mozhi66/smart-medicine-delivery-robot/项目介绍.md

# 智能药品小车 · 项目介绍

> 一台能听懂"我感冒了"、自己走到药架前、伸手把药取出来、还会提醒你怎么吃的智能药箱。
> 上位机 Python 负责「听、想、看」，下位机 STM32 负责「动」，两端用自定义串口协议通信。

---

## 一、项目要解决什么

家庭药箱的典型问题不是"没有药"，而是**找不到、记不住、拿不对**：

- 药盒堆在一起，临时找某种药要翻半天；
- 说明书上的用法用量看完就忘，老人尤其容易记混；
- 多种药混放，过期药和常用药分不清；
- 行动不便的人弯腰、伸手取药本身就有困难。

这个项目把"描述症状 → 拿到对的药 → 被告知怎么吃"压缩成一次对话。用户只需要说一句"我感冒了"或者"头有点疼"，剩下的定位、取药、核验、播报由系统完成。

**设计上的一条硬原则**：机器可以慢，但不能拿错药。所以整个流程里有两道强制核验 —— 抓取后必须送到固定扫码位复核二维码，不一致就放回并报警；高风险药品取用前必须语音二次确认。

---

## 二、系统总览

```
                 用户语音："我感冒了"
                        │
                        ▼
   ┌──────────────────── PC 端（Python 3.10）─────────────────────┐
   │                                                              │
   │   ASR (FunASR)          语音转文字                            │
   │        │                                                     │
   │        ▼                                                     │
   │   LLM (GLM-4-Flash)     症状 → 药品类别                       │
   │        │                                                     │
   │        ▼                                                     │
   │   药品知识库             类别 → 具体药品 + 槽位号              │
   │        │                                                     │
   │        ▼                                                     │
   │   视觉 (OpenCV)          USB 摄像头识别列二维码 / 槽位有无     │
   │        │                                                     │
   │        ▼                                                     │
   │   状态机                 对列 → 抓取 → 过检 → 交付 → 播报      │
   │        │                                                     │
   │        ▼                                                     │
   │   点位表 (PoseTable)     槽位 → 四路舵机角度序列               │
   │                                                              │
   └──────────────────────────┬───────────────────────────────────┘
                              │  USB 串口 115200 8N1
                              │  ASCII 帧：$CMD,args*XOR\r\n
                              ▼
   ┌──────────────────── STM32F103C8T6（裸机）────────────────────┐
   │                                                              │
   │   protocol.c   帧解析 / XOR 校验 / 指令分发                    │
   │   servo.c      4 路 PWM(50Hz) + TIM3 1ms 线性插值             │
   │   chassis.c    麦轮逆解 + 定时运动 + 失联自停                  │
   │   main.c       主循环 + HC-05 单字符手动通道                   │
   │                                                              │
   └──────────────────────────┬───────────────────────────────────┘
                              │
              ┌───────────────┴───────────────┐
              ▼                               ▼
      4 路舵机机械臂                    四轮麦轮底盘
      (3 俯仰关节 + 夹爪)              (TB6612 双路驱动)
```

**职责划分得很干净**：STM32 不做视觉、不做逆解、不做决策，只可靠地执行角度序列和速度指令，回 `$ACK` / `$DONE` / `$CHS` / `$HB`。所有"聪明"的部分都在 PC 上，改算法不用重新烧固件。

---

## 三、一次完整的取药流程

以"我感冒了"为例：

| 步骤 | 发生了什么 | 关键动作 |
|---|---|---|
| 1. 唤醒 | 用户按键或语音触发 | 状态机进入 `LISTEN` |
| 2. 识别 | FunASR 把语音转成文字 | `我感冒了` |
| 3. 理解 | GLM-4-Flash 映射到药品类别 | `感冒药` |
| 4. 定位 | 查药品知识库，取第一个可用槽位 | `MED001 感冒灵颗粒 → 槽位 1` |
| 5. 对列 | 底盘横移，摄像头读列二维码校正 | `$MV,0,x,0,tt` + `COLn` 校正 |
| 6. 抓取 | 查点位表，下发四舵机角度序列 | `$SA,a1,a2,a3,a4,tt` |
| 7. **过检** | 把药瓶送到固定扫码位二次识别 | 二维码 ≠ 目标 → 放回 + 报警 |
| 8. 交付 | 机械臂送到取药口，TTS 播报用法 | `开水冲服，一次一袋，一日三次` |
| 9. 归位 | 机械臂回 HOME，底盘待命 | `$HOM` |

第 7 步是整个项目里最值得说的一环。**"抓错了怎么办"是这类系统真正落地时绕不过去的问题** —— 视觉在抓取瞬间可能被遮挡、反光、角度干扰，一旦抓错又直接交给用户，后果比"没抓到"严重得多。所以设计上强制增加一个固定扫码位：不管前面多自信，都要在交付前再验一次身份。

---

## 四、硬件组成

| 部件 | 型号 / 规格 | 说明 |
|---|---|---|
| 主控 | STM32F103C8T6 | 最小系统板，72MHz，64KB Flash |
| 机械臂 | 4 路舵机 | s0 底座旋转、s1/s2 俯仰、s3 夹爪 |
| 舵机电源 | 5–6V / ≥5A 独立供电 | **只与主控共 GND**，避免舵机电流拉垮 MCU |
| 底盘 | 四轮麦克纳姆轮 | 可全向平移，适合货架前的横向对位 |
| 电机驱动 | TB6612 | 双路，**STBY 必须拉高** |
| 串口 | CH340 USB 转串口 | USART1，115200 8N1 |
| 蓝牙 | HC-05 | 手机手动控车通道 |
| 视觉 | USB 摄像头 | 固定于药箱前上方，俯视药架 |
| 显示 | OLED (I2C) | 显示状态与舵机速查表 |

**机械臂构型**：平面 3R 串联臂（3 个俯仰关节）+ 1 路夹爪。末端只能在一个竖直平面内运动，靠底座旋转覆盖不同列 —— 这个约束是刻意的，平面臂比 6 轴臂便宜、好标定、重复精度够用。

---

## 五、软件架构

### 5.1 上位机（Python）

```
智能药箱系统/
├── pc/
│   ├── main.py              主控入口：装配所有部件 + 主循环
│   ├── audio/               asr.py（FunASR 识别）、tts.py（语音播报）
│   ├── comm/                serial_protocol.py（帧编解码）
│   │                        arm_controller.py（机械臂控制）
│   │                        chassis_controller.py（底盘控制，继承前者）
│   ├── core/                state_machine.py（取药流程）
│   │                        kinematics.py（逆运动学）
│   │                        pose_table.py（槽位 → 角度）
│   │                        medicine_kb.py（药品知识库）
│   ├── llm/                 providers.py（多供应商预设）、glm_client.py
│   └── vision/              camera.py、qr_detector.py、scan_view.py、gui.py
├── config/                  app.yaml、medicines.json、poses.json
├── tools/                   标定、检查、标签生成等 23 个工具脚本
└── tests/                   端到端流水线测试
```

模块之间靠接口解耦：`ArmController` 有 Mock 实现，没有硬件也能跑通全流程；LLM 有 6 家供应商预设，换模型只改配置；视觉有 MockCamera，可以用图片回放代替实时摄像头。

### 5.2 固件（C，Keil SPL）

```
0stm/
├── app/
│   ├── main.h        舵机与系统参数、限位、Flash 配置版本
│   ├── servo.c       4 路 PWM + 1ms 插值 + 软限位预检 + 防烧保活
│   ├── chassis.c     麦轮逆解 + 定时运动 + deadman 失联自停
│   └── protocol.c    $ 帧解析、XOR 校验、指令分发
├── user/main.c       主循环 + HC-05 单字符手动通道
├── my_lib/           OLED / I2C / SPI / USART / 按键驱动
└── std_periph_driver/ STM32F10x 标准外设库
```

固件用标准外设库而非 HAL，代码体积小、启动快、时序可控。舵机 PWM 走 TIM2 四通道 50Hz，插值靠 TIM3 1ms 中断推进，避免舵机突变抖动。

---

## 六、关键技术点

### 6.1 平面 3R 逆运动学与槽位可达性

机械臂末端位置由三个俯仰角决定，逆解用几何法（余弦定理）求解，再按舵机限位裁剪。

设计阶段做了一次可达性验证，结论直接改变了机械布局：

| 布局 | 可达槽位 | 结论 |
|---|---|---|
| 弧形（朝向基座） | **8 / 8** | ✅ 采用 |
| 矩形 | 7 / 9 | ❌ 最远列接近角 -12.6°，太平夹不住 |

逆解回代误差 **< 0.3mm**。这个数字不是算出来的漂亮值，而是把解出的角度代回正运动学、和期望坐标比对得到的。

### 6.2 二维码识别：多后端融合

单一识别后端在真实光照下不够稳，所以做了 `aruco + builtin` 双后端融合，配合投票窗口（`accept_votes`）抑制误判。

抗干扰测试结果：

| 干扰类型 | 表现 |
|---|---|
| 噪声 / 变暗 / 旋转 / 透视 | **8 / 8 稳定识别** |
| 高斯模糊 k ≥ 5 | 开始掉 |
| 缩放 < 0.5 倍 | 开始掉 |

结论落到硬件要求上：**必须加环形补光 + 二维码留足静区**。

### 6.3 串口协议设计

帧格式 `$CMD,args*XOR\r\n`，XOR 为 `$` 与 `*` 之间全部字节异或，两位大写 HEX。选 ASCII 而非二进制，是为了能直接用串口助手肉眼调试。

底盘与机械臂的应答语义做了明确区分：

- **机械臂**：`$ACK` 收到 → `$DONE` 执行完（有明确终点）
- **底盘**：只回 `$ACK` + `$CHS` 状态帧，**不回 `$DONE`**

原因：底盘连续运动没有天然终点。早期版本让 PC 死等 `$DONE`，结果每次横移都超时。改成"发完即走 + 定时/状态帧反馈"后问题消失。

### 6.4 麦轮运动学与失联自停

逆解固定为：

```
FL = y + x + rx
FR = y - x - rx
RL = y - x + rx
RR = y + x - rx
```

安全设计上区分两种运动：

| 类型 | 触发 | 停止方式 |
|---|---|---|
| 定时运动 | `tt > 0` | 到点自停（**不受 deadman 打断**） |
| 连续运动 | `tt = 0` | 靠 `$MS` 或失联自停 |

失联阈值按模式区分：**AUTO 800ms / MANUAL 3000ms**。定时运动必须豁免 deadman，否则 1000ms 的横移会被 800ms 提前掐断 —— 这个坑实际踩过。

### 6.5 语音链路

- **ASR**：FunASR `paraformer-zh` + `fsmn-vad` + `ct-punc`，本地推理，不依赖云服务
- **LLM**：GLM-4-Flash（OpenAI 兼容协议），只做"症状 → 药品类别"这一件事，不让它自由发挥
- **TTS**：优先 edge-tts，不可用时回退 pyttsx3（SAPI5）

**为什么不让大模型直接给药品名**：幻觉风险。让模型输出受控的类别标签，再由本地知识库映射到具体药品和槽位，错误可以被枚举和兜底。

### 6.6 舵机保护

- **软限位预检**：`$SA` 里任一角度越限 → 整条指令拒绝，所有舵机不动（"先全查再动作"）
- **限位存 Flash**：带 magic + version + checksum，掉电不丢
- **防烧保活**：夹爪慢速闭合 + 堵转检测，避免长时间堵转烧舵机

---

## 七、两种工作模式

| | `auto` 全自动 | `manual_phone` 手机手动 |
|---|---|---|
| 底盘 | PC 发 `$MV` 定时横移 + 列码校正 | **PC 不发移动指令**，人用手机控车 |
| 固件模式 | `$MD,AUTO` | `$MD,MAN` |
| 失联自停 | 800ms | 3000ms |
| 拔瓶动作 | `$MV` 后退（`lift_dz=0`） | TTS 提示人工退开车 |
| 控制权 | PC 最近 300ms 发过 `$MV` 则忽略手机 | 手机全权 |

保留手动模式的原因是**演示和调试的现实需要**：自动对位在实验室能跑，但现场光照、地面平整度、药架位置都可能变，留一条人工兜底路径比追求全自动更实用。

手机通过 HC-05 发单字符：`F B L R`（前后左右）、`Q E`（原地转）、`Z C`（斜移）、`G H`（机械臂）、`S`（停）、`+ -`（调速）。

---

## 八、可靠性设计汇总

| 风险 | 对策 |
|---|---|
| 抓错药 | 过检位二次扫码，不一致放回 + 报警 |
| 误取高风险药 | `high_risk=true` 强制语音二次确认 |
| 底盘失控 | deadman 失联自停（800ms / 3000ms） |
| 舵机越限损坏 | 指令级全量预检，任一越限整条拒绝 |
| 舵机堵转烧毁 | 慢速闭合 + 堵转检测 + 防烧保活状态机 |
| 配置丢失 | 限位写 Flash，带版本号与校验 |
| 串口半帧 / 粘包 | 帧解析器带缓冲与超时丢弃 |
| 大模型幻觉 | 只输出受控类别标签，映射交给本地知识库 |

---

## 九、测试与验证

| 项目 | 方法 | 结果 |
|---|---|---|
| 端到端主流程 | 正常 / 高风险确认 / 抓错放回 / 空槽 / 未知药品 | **45 / 45 通过** |
| 逆解精度 | 角度回代正运动学比对 | 误差 < 0.3mm |
| 槽位可达性 | 弧形 vs 矩形布局 | 弧形 8/8，矩形 7/9 |
| 二维码鲁棒性 | 噪声 / 变暗 / 旋转 / 透视 / 模糊 / 缩放 | 前四类 8/8，模糊与缩放有阈值 |
| 串口协议 | 帧构建 / 校验 / 半帧 / 粘包 / 脏数据 | 自洽通过 |
| 固件 | 静态审查（include 链、extern 声明、函数定义、中断表） | 通过；**未做真机编译验证** |

**诚实说明**：固件部分是在没有 ARM 工具链的环境下做的静态审查，没有经过 CI 编译。实际编译需要 Windows + Keil MDK，仓库里提供了静态检查脚本 `tools_firmware_static_check.py`。

---

## 十、技术栈

| 层 | 技术 |
|---|---|
| 语音识别 | FunASR（paraformer-zh + fsmn-vad + ct-punc） |
| 语义理解 | GLM-4-Flash / DeepSeek / 通义千问 / Kimi / SiliconFlow / OpenAI（可切换） |
| 视觉 | OpenCV（二维码多后端融合、色块、帧差） |
| 上位机 | Python 3.10，无 ROS |
| 通信 | 自定义 ASCII 帧协议，XOR 校验，115200 8N1 |
| 固件 | C，STM32 标准外设库，Keil MDK |
| 硬件 | STM32F103C8T6 + 4 舵机平面臂 + 四轮麦轮 + TB6612 + HC-05 |

---

## 十一、项目结构

```
.
├── 0stm/                         STM32 固件（Keil 工程）
├── 智能药箱系统/                  上位机（Python）
│   ├── pc/                       主控、语音、视觉、通信、状态机
│   ├── config/                   配置、药品库、点位表
│   ├── docs/                     环境搭建、联调、审查报告
│   ├── tools/                    标定与检查工具
│   └── tests/                    端到端测试
├── 融合说明.md                    协议权威定义与设计取舍
├── 从零上手与硬件接线指南.md       接线与烧录流程
├── 项目介绍.md                    本文件
└── 项目说明_四轮麦轮融合版.docx     项目说明文档
```

---

## 十二、已知局限

写在这里，是为了不让人踩我已经踩过的坑：

- **固件未经真机编译验证** —— 只有静态审查，实际编译需 Keil MDK 环境
- **`tools/camera_check.py`、`tools/camera_preview.py` 为残缺片段**，不能独立运行
- **部分文档不完整** —— `从零上手与硬件接线指南.md` 仅保留烧录章节，`docs/` 下数篇为摘录或重建版本
- **位姿表需按硬件重新标定** —— `config/poses.json` 的数值来自特定样机，换舵机或换结构必须重跑 `tools/pose_demo.py`
- **未做长时间稳定性测试** —— 目前验证以功能正确性为主，缺少连续运行的老化数据

后续可以做的方向：加入药品库存自动盘点（视觉槽位监测已经在做，可以扩展到数量统计）、接入电子病历或用药记录、把过检位改成双摄像头交叉验证。
