mozhi66/smart-medicine-delivery-robot/从零上手与硬件接线指南.md

1. ST-Link 接好 SWD 四线（见 4.2），板子上电
2. Keil → `Options for Target → Debug` → 换成 **ST-Link Debugger**
3. `Options for Target → Utilities → Settings → Flash Download` 勾 **Reset and Run**
4. **F8 下载**（或点 Download 按钮）
5. 板子复位后 LED(PC13) 应开始闪烁；舵机应**平滑归位**到 HOME

#### C3. 串口连通性（关键一步，先不接舵机电源）

1. CH340 插电脑，设备管理器看是 **COM几**（认准 `USB-SERIAL CH340`）
2. 改 `config/app.yaml`：
   ```yaml
   serial:
     port: COM5      # ← 改成你的实际端口
     baud: 115200
   ```
3. PyCharm Terminal 里（先 `cd "智能药箱系统"`）：
   ```
   python pc/main.py --list-ports
   ```
   确认端口在列表里
4. 单独测机械臂通不通（**此时舵机可以还没接**，只要能看到 ACK/DONE 就算通）：
   ```
   python pc/main.py --real-tts --once --text "我感冒了"
   ```
   终端应打印 `$READY` → `$ACK,SA` → `$DONE,SA` …

> ⚠ 如果一直卡在"等待 READY"，99% 是 **TX/RX 接反了**（PA9→CH340 的 RXD，PA10→CH340 的 TXD），或者忘了 **GND 共地**。

#### C4. 接上舵机电源，标定机械臂

1. 先只接 **1 个舵机**（建议底座 servo0），通电，跑 `$SS,0,90,800` 看它是否转到中位
2. 逐个确认方向（`SERVO0_INVERT` 等宏可翻转）、确认限位（别顶到机械限位）
3. 4 个都接上，跑 `$HOM` 看是否平滑归位
4. 用 `$CFG,id,min,max` 给每个舵机设安全限位（真机会写进 Flash，掉电不丢）
5. **验证四个工作位能不能摆出来**：先 `python tools/pose_demo.py --show` 离线核对角度  
   （不接板子、不空跑，只打印姿态表 + 限位体检），没问题再跑  
   `python tools/pose_demo.py --port COM3`（PyCharm 里选 ⑭ 配置），  
   进去按 `a` / `b` / `c` / `d`（或数字 `1`~`4`）逐个走。  
   四个位姿与照片一一对应（编号按末端高度从上往下排）：
   | 编号   | 姿态     | s0/s1/s2/夹爪                  | 末端高度   | 照片  |
   | ---- | ------ | ---------------------------- | ------ | --- |
   | A(1) | 复位立正   | 180.0 / 120.0 / 120.0 / 20.0 | 290 mm | 图片一 |
   | B(2) | 取【上层】药 | 180.0 / 120.0 / 30.0 / 60.0  | 215 mm | 图片二 |
   | C(3) | 取【中层】药 | 180.0 / 40.0 / 110.0 / 60.0  | 194 mm | 图片四 |
   | D(4) | 取【下层】药 | 110.0 / 120.0 / 110.0 / 60.0 | 148 mm | 图片三 |
   > 表里的数字是 **2026-09-16 真机微调后的结果**，不是算出来的；  
   > 末端高度是按这套数字反算的，用来交叉核对 —— 差太远说明 `app.yaml` 里的  
   > `h0/l1/l2/l3` 该重新量了。
   像了就算标定没问题；不像就微调：进去先看屏幕上的「舵机速查表」，然后  
   `+ <舵机> [步长]` / `- <舵机> [步长]` 一小步一小步逼近（例 `+ 1 2` = s1 加 2°），  
   每步都会打印新的「末端 (x,z)」；挪过头按 `u` 回退，看总改动按 `delta`，  
   调好按 `w` 存回 `config/pose_demo.yaml`（注释会保留）。

   调单个位姿时别整轮跑：`python tools/pose_demo.py --port COM3 --only 2 --hold 60`  
   只跑第 2 个、停 60 秒，改一次跑一次最快。
   > ★ **方向约定**（三个定位舵机一样）：角度增大 = 那一段绕自己的关节逆时针 = 末端往上/后；  
   > 角度减小 = 顺时针 = 末端往下/前。**只有夹爪反过来：角度大 = 张开，角度小 = 夹紧**。  
   > 拿不准就改 1~2°，看打印出来的 (x,z) 怎么变，比背规则快。
   >
   > ★ **最好记的参照点**：`s0 = s1 = s2 = 90` 时三段绝对角是 `0° / 0° / -90°`  
   > （前两段水平前伸、第三段竖直朝下）。先跑到这里看清「水平」长什么样。
   >
   > ★ **两个常见误解**：①「三个 90 = 整条臂水平前伸」只对前两段，第三段是竖直朝下的；  
   > ②「s2 调大就能把三节拉直」做不到 —— 共线要 `s2 = 180`，固件上限 150。
   >
   > 常用命令：`a/b/c/d` 或 `1~4` 走姿态 · `+`/`-` 微调 · `set s0 s1 s2 [夹爪]` 四轴一起设 ·  
   > `step` 改默认步长 · `u` 回退 · `delta` 看差值 · `p` 打印可粘贴片段 ·  
   > `w` 存回文件 · `e` 汇总本次改动 · `guide` 重看速查表 · `q` 退出

> ★ 关于四姿态，两件事先知道，省得白折腾：
>
> 1. **自动模式默认每个位姿都「复位 → 位姿 → 复位」**（`--no-home-each` 可关）。  
>    去和回走同一条路径，去的时候没撞、回来也不会撞；  
>    位姿之间直接切换会让末端在扇形里大范围扫掠，容易带倒药瓶或扫到人手。
> 2. **这四个位姿 s2 最大只用到 120，没有顶到 150 的固件上限**，正常不会堵转嗡鸣。  
>    但下面这条物理缺口还在：`s2_home = 180`（几何上「第三段与第二段共线」要求 s2 = 180），  
>    固件 `SERVO2_LIMIT_MAX_DEG = 150`，所以**第三段永远比第二段低至少 30°**。  
>    要彻底解决只能改固件限位或重标定 `s2_home`。

> ⚠ **机械臂装好之前不要通电**，否则舵机会带着连杆乱撞。
