mozhi66/smart-medicine-delivery-robot/融合说明.md

# 智能药箱 · 融合版说明

> 由文件夹 **0** 与 **1** 各取优势合并而成。  
> 目标：一套可跑自动对列取药、也可手机手动控车、协议不记反、接线可查表的工程。

---

## 1. 取舍原则（为什么这样融）

| 来源 | 采纳的优势 | 落点 |
|---|---|---|
| **0** | 定时短移 `tt`、共串口 `ChassisController ⊂ ArmController`、闭环对列+列码校正、`lift_dz=0` 底盘拔瓶、硬件连接总表/换板清单/审查避坑 | 固件 `CHASSIS_Move(y,x,rx,ms)`、PC 对位与拔瓶、`0stm/硬件连接总表.md` |
| **1** | 指令命名消歧、`$MD` 双模式一等公民、失联自停 AUTO 800ms / MANUAL 3s、HC-05 单字符手动路径、2 电机试车、固件静态检查 | 协议 `MD/MV/MS/MC/MQ`、`chassis.c` deadman、`tools_firmware_static_check.py` |
| **审查修复** | 不再死等 `$DONE,MV`；`MS` 停车 / `MC` 限速不再记反；急停补 `$MS` | `chassis_controller.py` 全部 `wait_done=False` |

**不融合的：** 0 的 `MVS/MVC` 命名（易反）、1 的 auto 对位空壳（保留 0 的闭环）。

---

## 2. 融合后协议（唯一权威）

臂指令不变：`SA SS GC RUN HOM QRY EST CFG`

| 指令 | 格式 | 语义 |
|---|---|---|
| **MD** | `$MD,AUTO\|MAN\|Q` | 工作模式；Q 只查询 |
| **MV** | `$MV,y,x,rx[,tt]` | 运动；y/x/rx∈[-1,1]；tt=ms 可省（省略/0=连续） |
| **MS** | `$MS` | **立即停车** |
| **MC** | `$MC,pct` | **速度上限** 0~100（0=锁死） |
| **MQ** | `$MQ` | 查询 → `$CHS,mode,moving,y,x,rx,pct` |

- 底盘运动帧 **只回 `$ACK` + `$CHS`，不回 `$DONE`**
- 速记：**M**ode / **M**ove / **S**top / **C**ap / **Q**uery

手机 HC-05 单字符（不变）：`F B L R Q E Z C G H S + -`

---

## 3. 运动模型

```
tt > 0   定时运动   → 到点 CHASSIS_Update 自停（对列短移 / 拔瓶后退）
tt = 0   连续运动   → 靠 $MS 或失联自停（AUTO 800ms / MANUAL 3000ms）
```

- 定时运动 **不受** deadman 提前掐断（否则 1000ms 横移会被 800ms 打断）
- 连续运动 **必须** 受 deadman（手机松手/掉线即停）

麦轮逆解（不可改）：
`FL=y+x+rx  FR=y-x-rx  RL=y-x+rx  RR=y+x-rx`

---

## 4. 两种工作模式

| | auto | manual_phone |
|---|---|---|
| 底盘 | PC 发 `$MV` 定时横移 + 列码 `COLn` 校正 | **PC 不发移动指令**；TTS 报列，人用手机 HC-05 控车 |
| 固件模式 | `$MD,AUTO` | `$MD,MAN` |
| 失联自停 | 800ms | 3000ms |
| 拔瓶 | `$MV` 后退（`lift_dz=0`） | TTS 提示人工退开车 |
| 抢控制权 | PC 最近 300ms 内发过 `$MV` 则忽略手机字符 | 手机全权 |

---

## 5. 目录

```
融合版/
├─ 0stm/                     Keil 固件（臂+底盘合并）
│  ├─ app/protocol.*         MD/MV/MS/MC/MQ + $CHS
│  ├─ app/chassis.*          定时运动 + 模式 + 失联自停
│  ├─ app/servo.* / main.h   舵机与参数（0 版更全）
│  ├─ user/main.c            指令分发 + HC05
│  ├─ 硬件连接总表.md         查表（0）
│  ├─ 换板子检查清单.md       换板（0）
│  └─ tools_firmware_static_check.py  静态检查（1）
├─ 智能药箱系统/              PyCharm 上位机
│  ├─ pc/comm/chassis_controller.py  融合控制器
│  ├─ pc/core/state_machine.py       闭环对位 + lift_dz=0
│  └─ docs/代码审查报告_20260922.md  历史坑（对照用）
├─ 0底盘/HC05控制小车/        原底盘工程（参考）
└─ 从零上手与硬件接线指南.md
```

---

## 6. 上电 / 试车（融合 0 的顺序 + 1 的 2 电机法）

1. 只给 STM32 上电 → LED 1Hz 闪、串口 `$READY` + `$HB`
2. 接舵机电源（**5–6V ≥5A 独立，只共 GND**）→ 平滑到 HOME
3. **最低配置试车（来自 1）**：先只接 2 个电机（如 FL+FR）验 PWM/方向
4. 再接满 4 轮 + TB6612（**STBY 必须拉高**）→ `$MQ` 看 `$CHS`
5. 发 `$MV,0.5,0,0,1000` 前进 1 秒；`$MV,0,0.5,0,1000` 应**向右横移**
6. `$MS` 立即停；手机连 HC-05 按 `F`/`S`（需 PC 静默 >300ms）

---

## 7. 真机编译开关

`app/main.h`：`USE_RX_DMA=1`、`USE_IWDG=1`

改完跑：`python 0stm/tools_firmware_static_check.py`

---

## 8. 2026-09-29 HC05 命令集升级（融合 0hc05控制底盘和舵机 工程）

手机 HC05 通道由旧版"仅底盘 10 键"升级为**底盘 + 舵机完整遥控**（与 HC05 独占版 V2.0 一致）：

| 键 | 功能 | 回帧 |
|---|---|---|
| F B L R G H Q E Z C | 底盘十方向（连续运动） | `$ACK,<键>` |
| **S** | **急停：底盘+机械臂一起冻结** | `$ACK,S` |
| . / , | 加减速 ±10% | `$CHS` |
| **1~4** | 选舵机（1底座 2大臂 3小臂 4夹爪） | `$SEL,<号>,<角>` |
| **+ / -** | 当前舵机 ±10° 点动 | `$SEL,<号>,<目标角>` |
| **O / K** | 夹爪张开 / 闭合 | `$ACK,GC` |
| **=** | 四路归位 | `$ACK,HOM` |
| **?** | 查询 | `$POSE` + `$CHS` |
| 其他字母数字 | — | `$ERR,02,<键>` |

安全规则（本次同步修复/加固）：

1. **'S' 急停不受 PC 优先窗口限制**：原来 'S' 在 300ms 窗口检查之后，
   自动流程中按急停会被忽略 —— 已把急停判断挪到窗口检查之前。
2. **双向互斥带反馈**：舵机忙时底盘键回 `$ERR,06,ARM`；底盘动时舵机键回
   `$ERR,06,CHS`。手机上"按了没反应"能立刻看到原因，不再是静默忽略。
3. **PC 优先窗口保留**（`HC05_PC_PRIORITY_MS=300ms`）：PC 发过 `$MV` 后
   300ms 内手机命令（除 S）忽略，自动抓药途中手机误碰不会抢方向盘。
4. 修复：main.c 中 5 个 HC05 函数曾**重复定义两遍**（编译必错），已合并为一份。

新增协议帧：`$SEL,<1~4>,<角度>*CS`（`protocol.c: PROTO_SendSel`，只增不改，PC 端兼容）。

完整流程分工：
- **自动（PC 串口 115200）**：FunASR → GLM 映射药品 → `$SA/$SS/$GC` 抓药 → `$MV` 底盘对位 → 摄像头扫码 → TTS 播报完成
- **手动（HC05 串口 9600）**：手机控底盘到指定位置 → 1~4 + +/- 控舵机 → O/K 放下药品 → = 归位

---

## 9. 2026-09-29 夹爪防烧：扫角 + 夹紧保活（堵转保护）

痛点：S4 夹爪夹住药瓶/顶到机械卡位后舵机仍持续出力（SG90 无反馈，固件不知"已卡住"）→ 堵转发热烧机。

固件（`0stm`）新增三层保护（`main.h` 七·B 节 + `servo.c`）：

| 层 | 机制 | 参数 |
|---|---|---|
| 1. 慢速扫角 | `$GC,close`/HC05 `K` 的闭合时长强制 ≥1200ms，平稳逼近少冲击 | `GRIP_SCAN_CLOSE_MS=1200` |
| 2. 夹紧保活 | 运动结束时夹爪停在夹紧角（$GC,close、$SA 的 lift/deliver 点、HC05 点动到闭合）→ 自动进入"250ms 补压 + 1250ms 卸力(+4°)"循环；占空比 17%，平均电流约 1/5 | `GRIP_HOLD_ACTIVE_MS/REST_MS/BACKOFF_DEG` |
| 3. 干净退出 | 任何新运动（MotionStart）、急停 StopNow、ResetToDefault 自动退出保活，与插值/序列零冲突 | — |

总开关 `GRIP_HOLD_ENABLE`（main.h）。药瓶若在保活期松脱打滑 → 调小 `GRIP_HOLD_BACKOFF_DEG`（如 2.0f）。

PC 端新增扫角标定工具：

```
python tools/gripper_scan.py COM5        # 1°步进找卡位，回车续/n停
python tools/gripper_scan.py COM5 --mock # 无硬件演练
```

扫完按提示改 `main.h` 四个宏（CLOSE/OPEN/限位），卡位前留 2~3° 余量。

## 10. 2026-09-30 夹爪角度体系修正：45°=恰好闭合，限位锁死 45

实测结论：S4 夹爪转到约 **45° 时就物理闭合** —— 旧体系 `GRIPPER_CLOSE_DEG=0°` 会越过机械止点继续转，属于典型堵转（烧舵机根源之一）。

新体系（固件 / PC 全链路一致）：

| 项 | 旧值 | 新值 |
|---|---|---|
| 完全张开 / 复位 HOME | 90° | 90°（不变） |
| 夹紧 CLOSE（`$GC,close`） | 0°（堵转区） | **45°**（实测恰好闭合，约 1000us） |
| SERVO3 软限位 | 0~90 | **45~90**（下限锁死，越界指令拒收 `$ERR,03`） |
| `CFG_STORE_VERSION` | 2u | **3u**（作废 Flash 旧限位，上电自动重载新默认值） |

改动位置：
- 固件 `0stm/app/main.h`：`SERVO3_HOME_DEG=90`、`GRIPPER_CLOSE_DEG=45`、`SERVO3_LIMIT_MIN_DEG=45`、`CFG_STORE_VERSION=3u`
- PC 端：`config/poses.json`（inspect/deliver/9×lift 夹爪角 0→45、`gripper.close=45`）、`pc/core/pose_table.py`（HOME=90 / CLOSE=45）、`pc/core/kinematics.py`（`SERVO_LIMITS[3]=(45,90)`）、`config/app.yaml`（inspect/deliver 特殊位改 45）

验证：全 mock 冒烟通过（lift/inspect 位 `$SA` 帧夹爪角=45.0，全链 success）。

想加大夹持力（夹药瓶更紧）：把 `GRIPPER_CLOSE_DEG` 微调到 43~44，并**同步**放宽 `SERVO3_LIMIT_MIN_DEG`，改完用 `tools/gripper_scan.py` 复验不要一次调过头。
