mozhi66/smart-medicine-delivery-robot/项目说明_四轮麦轮融合版.docx

智能药箱系统 · 四轮麦轮融合版

项目说明（架构 · 协议 · 软件 · 硬件连接）

目录：项目根目录

# 1. 项目简介

本项目是一套「说话取药」智能药箱：用户描述症状 → 大模型理解 → 麦轮底盘对准货架列 → 四自由度平面机械臂抓取 → 过检扫码 → 交付并语音播报服药提示。

架构分工：PC（Python）负责「听、想、看」；STM32F103C8T6 负责「动」。两者通过 CH340 串口（USART1，115200）以 NMEA 风格 $ 帧协议通信。

# 2. 系统架构

- 上位机 pc/main.py：组装相机、串口、LLM、语音模块，交给状态机
- 状态机 core/state_machine.py：待机→听→理解→对列→抓取→过检→交付→播报
- 底盘控制器 comm/chassis_controller.py：继承 ArmController，共串口发 $MD/$MV/$MS/$MC/$MQ
- 固件 0stm：user/main.c 指令分发 + app/servo.c 舵机 + app/chassis.c 麦轮底盘 + app/protocol.c 协议

# 3. 通信协议

帧格式：$指令,参数...*校验\r\n（校验 = 帧体逐字节 XOR，2 位大写 HEX）

指令 | 格式 | 说明
SA | $SA,a1,a2,a3,a4,tt | 四舵机同步插值到角度（度）
SS / GC / HOM / QRY / EST / CFG | — | 单轴/夹爪/回零/查询/急停/限位
MD | $MD,AUTO|MAN|Q | 工作模式
MV | $MV,y,x,rx[,tt] | 底盘运动；y/x/rx∈[-1,1]；tt=ms（0=连续）
MS | $MS | 立即停车
MC | $MC,pct | 速度上限 0~100
MQ | $MQ | 查询 → $CHS,mode,moving,y,x,rx,pct

★ 底盘运动只回 $ACK + $CHS，不回 $DONE（PC 别死等）。

★ 速记：MD=Mode，MV=Move，MS=Stop，MC=Cap，MQ=Query。

# 4. 软件说明

## 4.1 上位机

模块 | 职责
pc/core/state_machine.py | 取药流程、auto/manual_phone 对列、lift_dz=0 拔瓶
pc/core/kinematics.py | 机械臂逆运动学
pc/comm/arm_controller.py | 串口收发、ACK/DONE 等待、mock
pc/comm/chassis_controller.py | 底盘 $MD/$MV/$MS/$MC/$MQ，共串口
pc/vision/* | 相机、二维码、槽位监测、中文渲染
pc/audio/* | FunASR 识别 + TTS 播报
pc/llm/* | 症状 → 药品类别（多供应商）

## 4.2 固件

文件 | 职责
user/main.c | 初始化、指令分发、HC05 手机命令（300ms PC 优先）
app/servo.c | TIM2 四路 50Hz 舵机、1ms 同步插值、限位、Flash
app/chassis.c | 麦轮逆解、TIM4 四路 1kHz PWM、定时运动、模式/deadman
app/protocol.c | $ 帧解析/组帧、$CHS 状态上报
app/main.h | 全部引脚/参数宏（唯一权威）

# 5. 硬件连接（完整）

## 5.1 总览

MCU：STM32F103C8T6（Blue Pill，72MHz，64KB Flash）

## 5.2 机械臂 4 舵机（TIM2，50Hz，500–2500us）【冻结】

舵机 | 引脚 | 通道 | 功能 | 型号建议
s0 | PA0 | TIM2_CH1 | 底座俯仰 | MG996R
s1 | PA1 | TIM2_CH2 | 大臂俯仰 | MG996R
s2 | PA2 | TIM2_CH3 | 小臂俯仰 | MG996R
s3 | PA3 | TIM2_CH4 | 夹爪（小=夹紧） | SG90

舵机供电：独立 5–6V ≥5A，只与 MCU 共 GND，VCC 绝不接板载 3.3V/5V。

## 5.3 麦轮底盘（2×TB6612FNG → 4 电机）

轮 | 方向 IN1 | 方向 IN2 | 速度 PWM
FL 前左 | PA4 | PA5 | PB6 (TIM4_CH1)
FR 前右 | PA6 | PA7 | PB7 (TIM4_CH2)
RL 后左 | PB0 | PB1 | PB8 (TIM4_CH3)
RR 后右 | PB12 | PB13 | PB9 (TIM4_CH4)

TB6612：VCC=3.3V 逻辑，VM=7–12V 电机电，STBY 必须拉高，全部共地。

麦轮 X 型安装；某轮反向改 chassis.c 的 s_dir_pol[i]=-1。

逆解：FL=y+x+rx，FR=y-x-rx，RL=y-x+rx，RR=y+x-rx（y=前进，x=右移，rx=顺时针）。

## 5.4 串口 / 蓝牙 / 调试

链路 | STM32 | 对端 | 波特率
USART1 | PA9 TX / PA10 RX | CH340 → PC | 115200
USART3 | PB10 TX / PB11 RX | HC-05 → 手机 | 9600
SWD | PA13 SWDIO / PA14 SWCLK | ST-Link | —
LED | PC13 | 板载 | 1Hz 心跳

## 5.5 电源

电源轨 | 负载
5–6V ≥5A | 舵机（独立，共 GND）
7–12V | 电机 VM
3.3V/5V | STM32 + HC-05 + TB6612 逻辑

## 5.6 上电顺序

- 1. 检查 VCC/GND；2. 只给 STM32 上电，看 $READY 与 LED 闪；
- 3. 再上舵机电源，舵机平滑到 HOME；4. 再上电机电源，轮子应静止；
- 5. 剧烈抖动立刻断电；关机顺序相反。

# 6. 两种工作模式

模式 | 底盘 | 安全
auto | PC 发 $MV 定时横移 + 列码校正 | deadman 800ms
manual_phone | 手机 HC-05 单字符，PC 不发移动指令 | deadman 3000ms

取药策略 lift_dz=0：夹住药瓶后不抬高，由底盘后退把药瓶从槽中拔出。

# 7. 避坑要点

- $MS=停车、$MC=限速、$MQ=查询 —— 不用旧名 MVS/MVC
- $MV 不回 $DONE，PC 用 wait_done=False
- STBY 必须拉高，否则 ACK 但车不走
- 急停：$EST 停臂 + $MS 停底盘
- 改引脚对照 app/main.h 与 换板子检查清单.md（AI生成）
