mozhi66/smart-medicine-delivery-robot/智能药箱系统/docs/PyCharm使用说明.md

> [原第25行] > 一句话：**Anaconda 只能跑"假语音"的仿真模式；只要涉及真麦克风、真 ASR，就必须用 Python 3.10。**
> [原第88行] | 2 | `tools/phase1_smoke.py --mic` | **想单独测麦克风/FunASR** | 不碰串口、不碰机械臂，只测"说话→文字"这一条 |
> [原第94行] ### ★ 先测麦克风，再跑主程序（强烈建议）
> [原第96行] **不要一上手就跑主程序录麦克风**——主程序要先等串口、再加载模型，出问题时你分不清是哪一环。
> [原第101行] | 1. 体检 | `python tools/check_env.py` | `没有阻塞项` + `[ OK ] 麦克风可用` |
> [原第103行] | 3. 想再稳一点 | `python tools/phase1_smoke.py --file <某个16k中文wav>` | 不依赖麦克风，纯测模型 |
> [原第106行] > 只要它通过，就证明"麦克风 + FunASR + 标点恢复"这条链路是好的。
> [原第126行] > | ① 测麦克风 phase1_smoke --mic | 单独测"对麦克风说话→文字" | `tools/phase1_smoke.py --mic` |
> [原第127行] > | ①b 第一阶段·纯文本(免麦克风) | 只测大模型，最快 | `tools/phase1_smoke.py --text "我感冒了"` |
> [原第128行] > | ①c 测麦克风·一直问(--loop) | 说不对就一直让你重说 | `tools/phase1_smoke.py --mic --loop` |
> [原第130行] > | ③ 主程序 假硬件+真麦克风+真大模型 | 真语音输入，但**只打印不发声** | `pc/main.py --mock --real-mic --real-llm` |
> [原第144行] > | ⑯ 四姿态Demo 查串口号 | 先跑这个确认 COM 号（蓝牙口不是你的板子） | `tools/pose_demo.py --list-ports` |
> [原第166行] | **全仿真 + 真麦克风**（对麦克风说话） | `--mock --real-mic` |
> [原第167行] | **全仿真 + 真麦克风 + 真大模型** | `--mock --real-mic --real-llm` |
> [原第168行] | **★ 全仿真 + 真麦克风 + 真大模型 + 真播报**（语音演示一条龙） | `--mock --real-mic --real-llm --real-tts --once` |
> [原第171行] | 全仿真 + 真麦克风 + 真扬声器 | `--mock --real-mic --real-tts` |
> [原第174行] | 看有哪些串口 | `--list-ports` |
> [原第186行] | **`--real-mic`** | **语音输入走真实麦克风 + FunASR** | **必须用 `Python 3.10`，且 funasr 已装** |
> [原第189行] > **为什么要有 `--real-mic`**：以前想"对麦克风说话"，只能不加 `--mock`；
> [原第190行] > 但不加 `--mock` 会先去开串口，没接 STM32 就直接退出，**根本轮不到麦克风**。
> [原第203行] 语音输入: 真实麦克风   语音播报: 打印(mock)
> [原第211行] | `--mock --real-mic` | 全仿真 | 本地规则 | **真麦克风** | 打印 |
> [原第212行] | `--mock --real-mic --real-llm` | 全仿真 | **真实调用** | **真麦克风** | 打印 |
> [原第213行] | `--port COM3` | 真实 | 真实调用 | 真麦克风 | 真扬声器 |
> [原第226行] > 要么先跑 `--mock`。查本机串口：`--list-ports`（会标出 `[USB]` / `[蓝牙]`）。
> [原第281行] **Q：跑 `pc/main.py` 它对麦克风没反应？**
> [原第282行] 先确认启动横幅第二行写的是 `语音输入: 真实麦克风`。如果写的是 `键盘输入(mock)`，
> [原第284行] 没加 `--real-mic` 时程序**根本不会碰麦克风**，它会等你在控制台敲字。
> [原第291行] 靠近麦克风、正常音量说一句；
> [原第292行] 4. **麦克风选错了**：默认输入设备是 `麦克风阵列(英特尔智音技术)`。
> [原第297行] **Q：戴蓝牙耳机（如 vivo TWS 3）时，对着耳机的麦克风说话能识别吗？**
> [原第298行] **能**。现在跑 `--mic` 时**会先弹出麦克风菜单让你输数字选**（直接回车=系统默认）：
> [原第301行] 检测到 18 个能录音的设备，请选择这次用哪个麦克风：
> [原第302行] 1) Microsoft 声音映射器 - Input  (44100Hz, 2ch)   （不是真麦克风，一般别选）
> [原第303行] 2) 麦克风阵列 (英特尔® 智音技术)  (44100Hz, 2ch)   [电脑内置]  <-- 回车直接用这个
> [原第320行] > 蓝牙免提模式的麦克风恰好是 16kHz 单声道 = ASR 要的采样率，音质"变差"不影响识别。
