mozhi66/smart-medicine-delivery-robot/智能药箱系统/docs/kinematics_arc.png

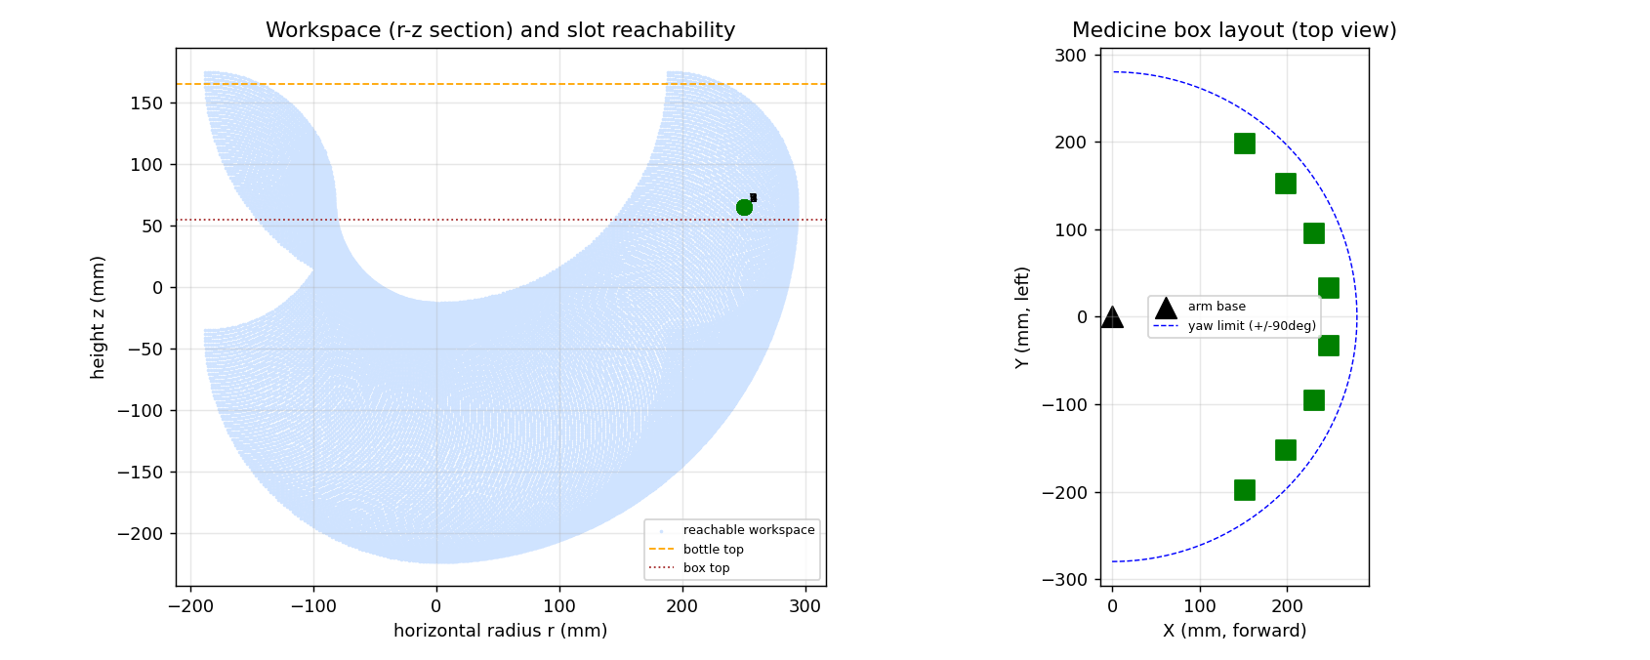
智能药箱系统/docs/kinematics_arc.png
