mozhi66/smart-medicine-delivery-robot/智能药箱系统/docs/kinematics_workspace.png

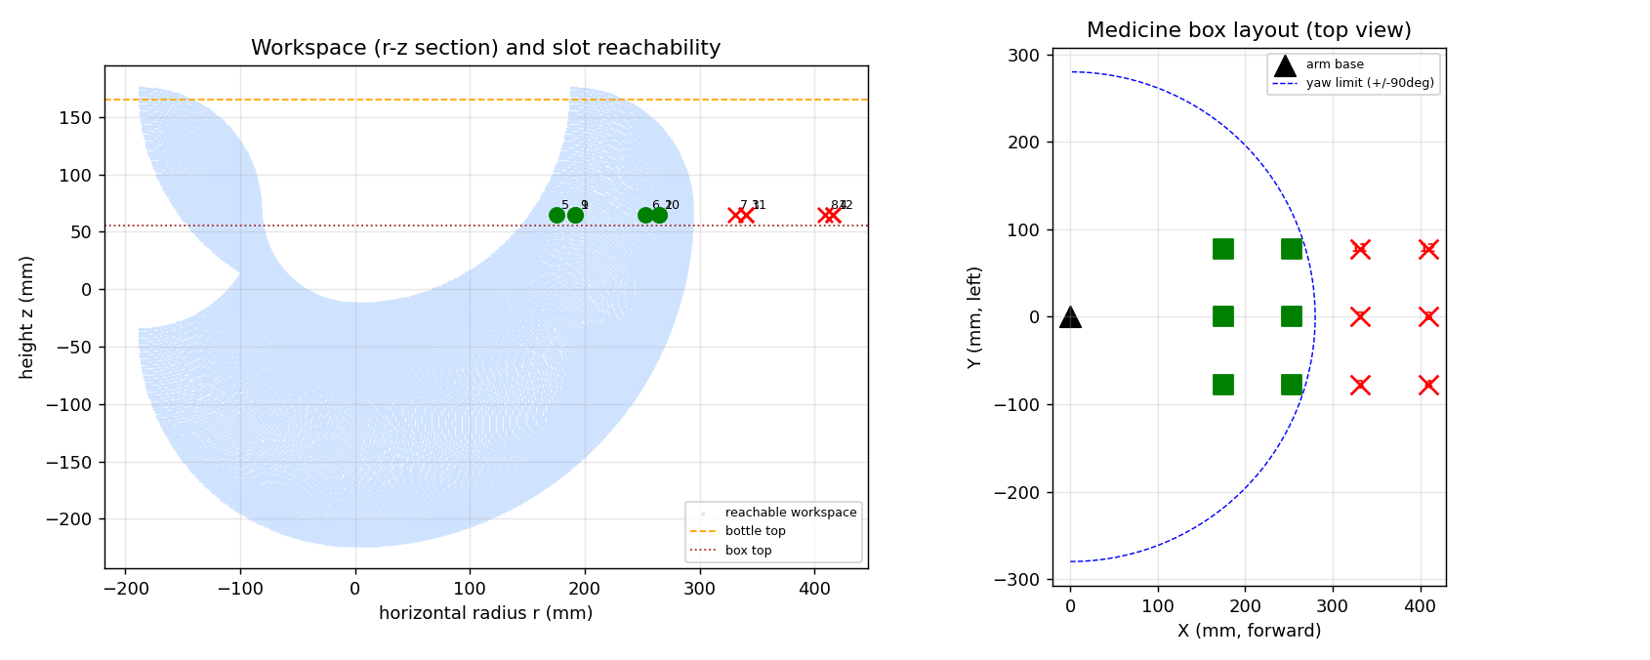
智能药箱系统/docs/kinematics_workspace.png
