mozhi66/smart-medicine-delivery-robot/智能药箱系统/docs/vision_sim_result.png

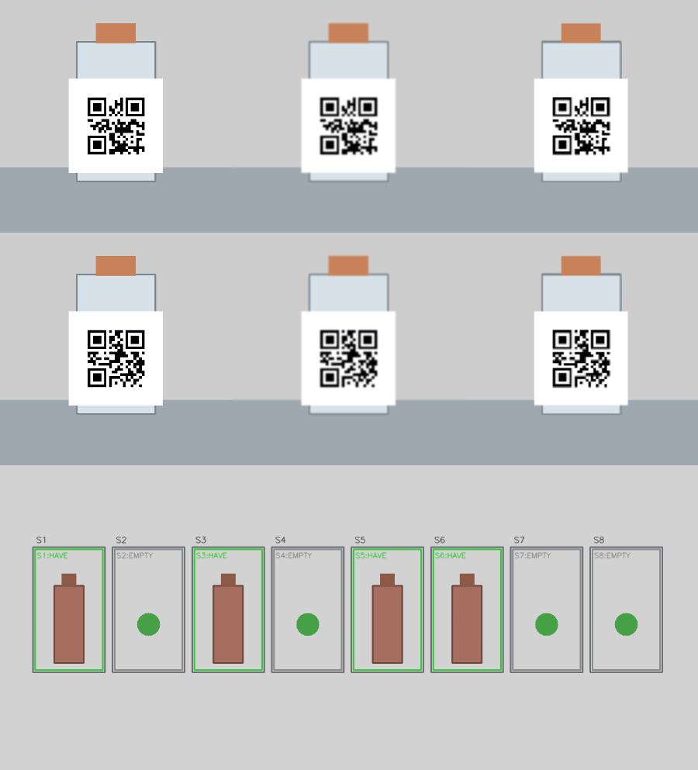
智能药箱系统/docs/vision_sim_result.png
