mozhi66/smart-medicine-delivery-robot/(commit log)

2026-10-31 Initial commit: 智能药箱 · 四轮麦轮融合版
    - 0stm: STM32F103 Keil 固件（4 舵机机械臂 + 麦轮底盘 + HC-05）
    - 智能药箱系统: Python 上位机（FunASR + GLM-4-Flash + OpenCV + 串口）
    - 文档: 融合说明 / 硬件接线指南 / 项目说明
2026-10-31 fix: 移除项目说明文档中的本地绝对路径
    原文含 `E:\0桌面\00\融合版`，已改为「项目根目录」。
2026-10-31 docs: 新增项目介绍文档
    覆盖项目目标、系统架构、取药流程、关键技术点、可靠性与测试验证。
